inopya/collar-luminoso-norma/imagenes/00 collar.jpg

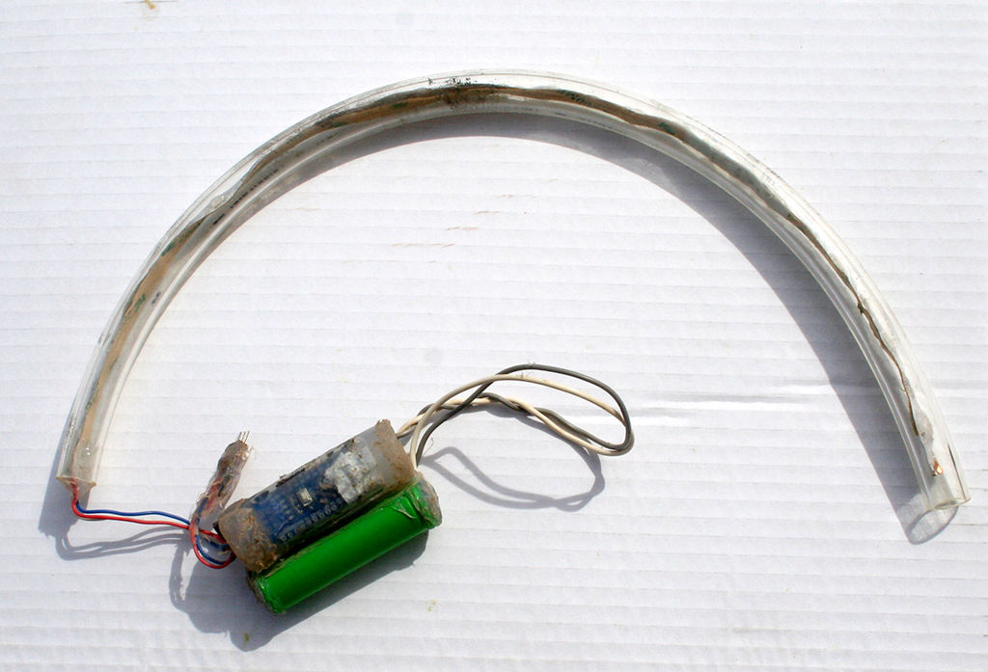
imagenes/00 collar.jpg
