inopya/collar-luminoso-norma/imagenes/level080.jpg

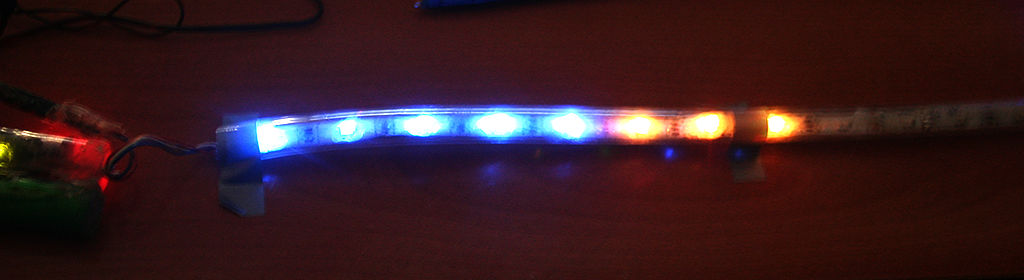
imagenes/level080.jpg
